Jelte-Boumans/Bachelorproef-Herstelsysteem-Ramen/Software/Assets/window_stap20.png

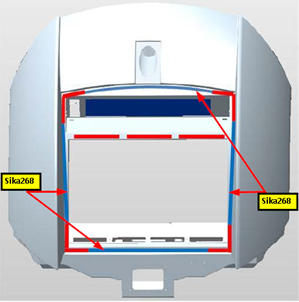
Software/Assets/window_stap20.png
