Jelte-Boumans/Bachelorproef-Herstelsysteem-Ramen/Software/Assets/window_stap22.png

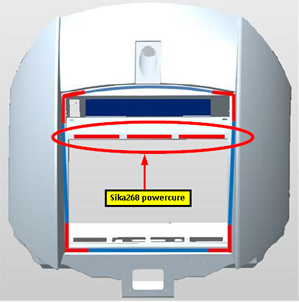
Software/Assets/window_stap22.png
