Jelte-Boumans/Bachelorproef-Herstelsysteem-Ramen/Documentatie/Analyse/Software analyse/Mockup Interface/Mockup - Powerpoint.pptx

## 1


## Slide 2
