Jelte-Boumans/Bachelorproef-Herstelsysteem-Ramen/Documentatie/Documenten/Foto's website/V2/Screenshot 2023-05-25 154047.png

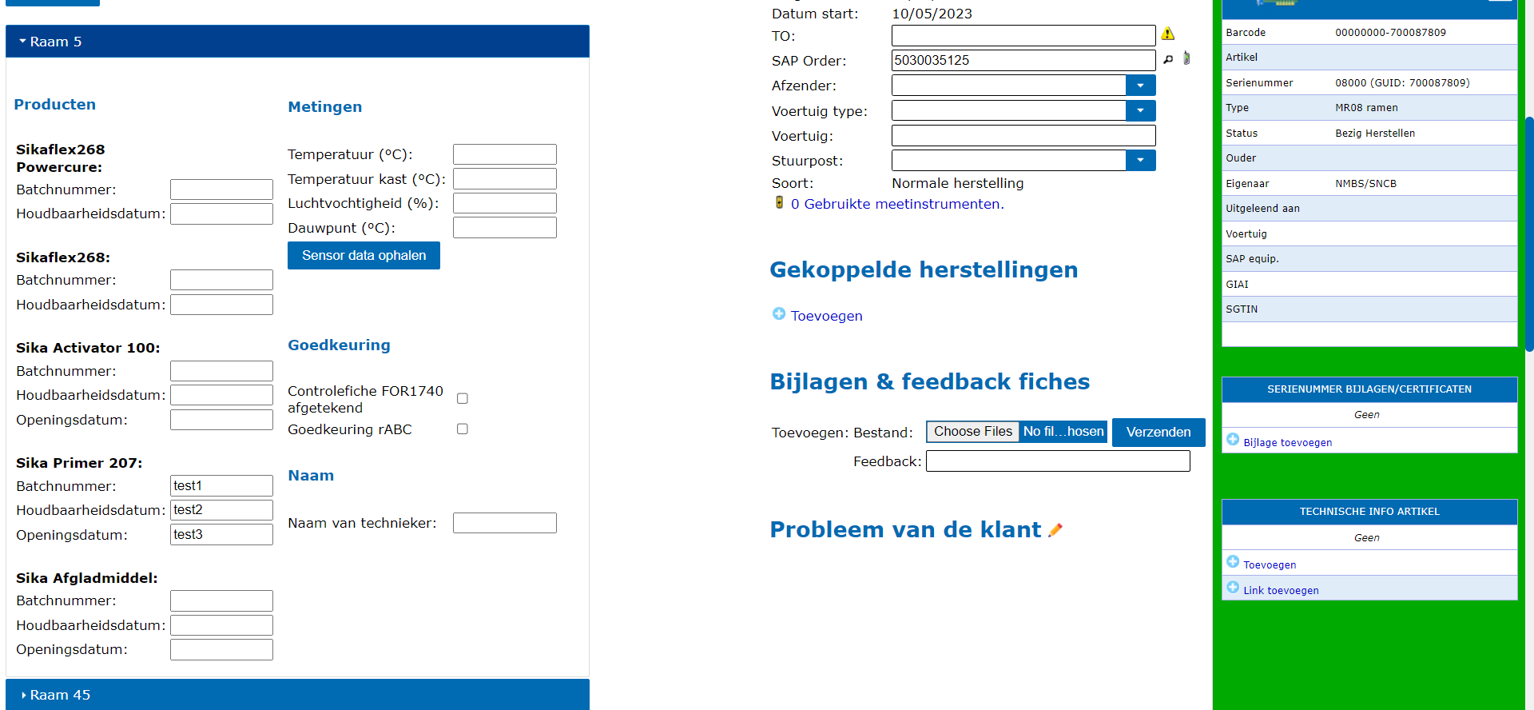
Documentatie/Documenten/Foto's website/V2/Screenshot 2023-05-25 154047.png
