Jelte-Boumans/Bachelorproef-Herstelsysteem-Ramen/Software/Assets/window_select.png

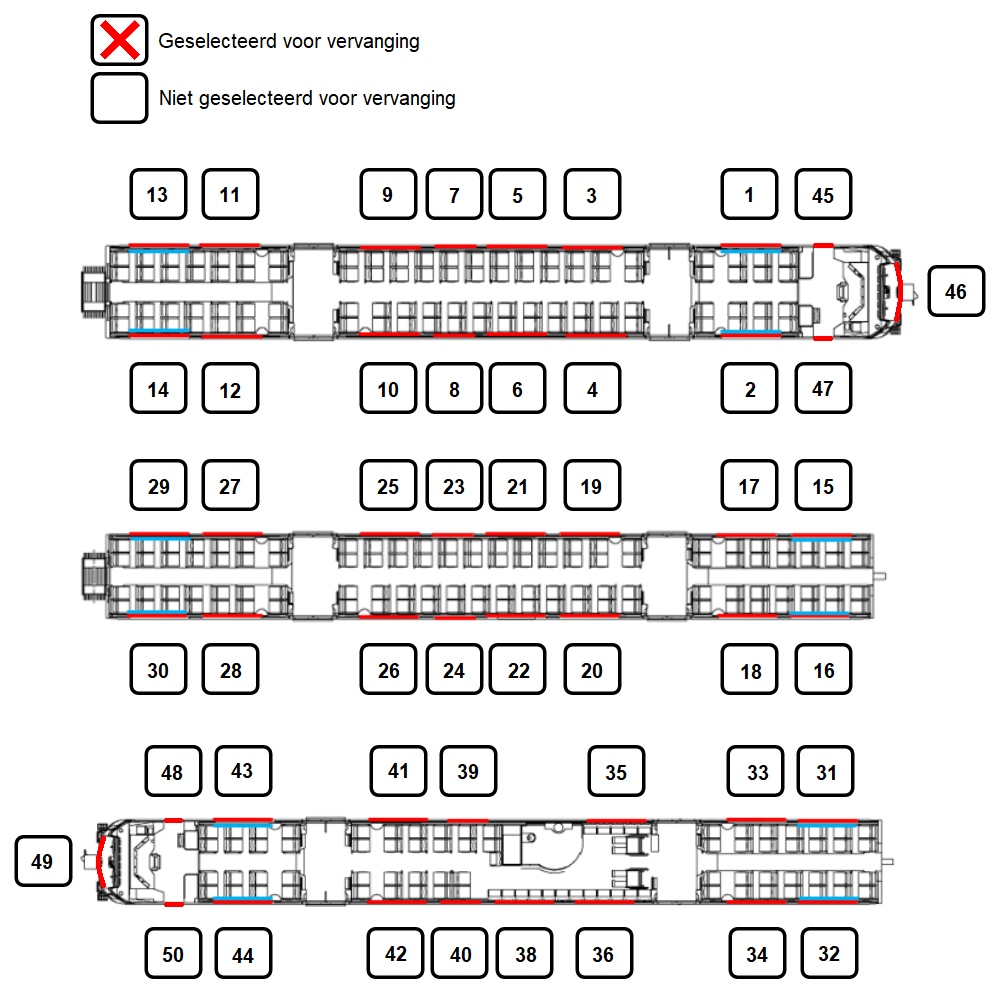
Software/Assets/window_select.png
