Jelte-Boumans/Bachelorproef-Herstelsysteem-Ramen/Documentatie/Analyse/Hardware analyse/V2/BOM.xlsx

Bill Of Materials - Stageopdracht Jelte Boumans
# | Qty | Component | Naam | Leverancier | Bestelnummer | Prijs/stuk | Prijs | Totaalprijs
1 | 1 | MCU | ATmega32U4 | Farnell | 1748525 | 5.180 € | 5.18 € | 36.51 €
2 | 1 | Sensor | BME680 | Mouser | 262-BME680 | 10.310 € | 10.31 €
3 | 1 | Spanningsregelaar | MCP1700T-3302E/TT | Farnell | 1296592 | 0.493 € | 0.49 €
4 | 1 | XTAL | LFXTAL071268 | Farnell | 2612479 | 1.140 € | 1.14 €
5 | 1 | Polyfuse | MSMF050-2 | Farnell | 9350314 | 0.500 € | 0.50 €
6 | 1 | Male USB C | CX60-24S-UNIT | Mouser | 798-CX60-24S-UNIT | 2.000 € | 2.00 €
7 | 1 | Display | Micro OLED 96x16 | Mouser | 790-EAW096016-XALW | 12.350 € | 12.35 €
8 | 1 | I2C level shifter | TCA9517DR | Farnell | 3009548 | 1.200 € | 1.20 €
9 | 1 | LED | SMD LED RED 0603 | Farnell | 2610406 | 0.365 € | 0.36 €
10 | 2 | LED | SMD LED GRN 0603 | Farnell | 2610409 | 0.365 € | 0.73 €
11 | 1 | Button | SMD Tactile Switch | Mouser | 611-PTS636SK50SMTRLF | 0.603 € | 0.60 €
12 | 5 | Weerstand | SMD 4k7Ω 0603 | Farnell | 2073509 | 0.012 € | 0.06 €
14 | 3 | Weerstand | SMD 1k5Ω 0603 | Farnell | 1717575 | 0.506 € | 1.52 €
15 | 2 | Weerstand | SMD 22Ω 0603 | Farnell | 2447301 | 0.013 € | 0.03 €
16 | 1 | Weerstand | SMD 10kΩ 0603 | Farnell | 2074167 | 0.010 € | 0.01 €
17 | 1 | Weerstand | SMD 910kΩ 0603 | Farnell | 2074318 | 0.013 € | 0.01 €
18 | 2 | Weerstand | SMD 5k1Ω 0603 | Farnell | 2447404 | 0.005 € | 0.01 €
19 | 2 | Condensator | SMD 100nF 0603 | Farnell | 2310603 | 0.007 € | 0.01 €
20 | 7 | Condensator | SMD 1µF 0603 | Farnell | 2210922 | 0.095 € | 0.66 €
21 | 2 | Condensator | SMD 22pF 0603 | Farnell | 1907288 | 0.044 € | 0.09 €
22 | 4 | Condensator | SMD 10µF 0603 | Farnell | 1867954 | 0.338 € | 1.35 €
