Jelte-Boumans/Bachelorproef-Herstelsysteem-Ramen/Hardware/Behuizing/Versie 1/Case V1 - Bovenkant.stl

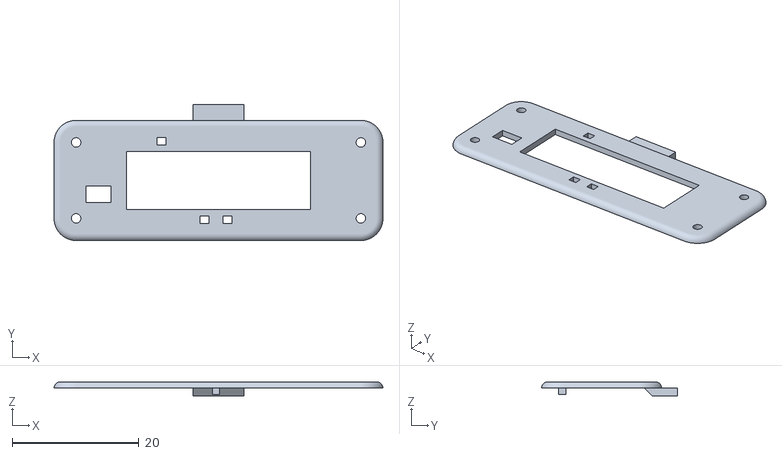
[picture p24: CAD file, 2023-05-04]
Hardware/Behuizing/Versie 1/Case V1 - Bovenkant.stl
52.0 x 21.5 x 2.25
