Jelte-Boumans/Bachelorproef-Herstelsysteem-Ramen/Hardware/Behuizing/Versie 2/Case V2 - Bovenkant.stl

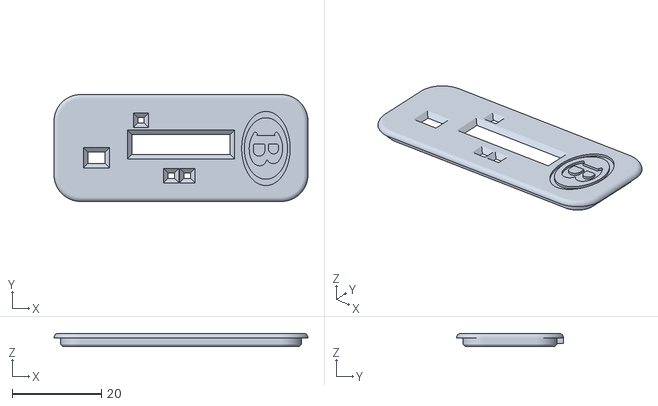
[picture p25: CAD file, 2023-05-04]
Hardware/Behuizing/Versie 2/Case V2 - Bovenkant.stl
57.0 x 24.0 x 3.00
