Jelte-Boumans/Bachelorproef-Herstelsysteem-Ramen/Hardware/Behuizing/Versie 1/Case V1 - Onderkant.stl

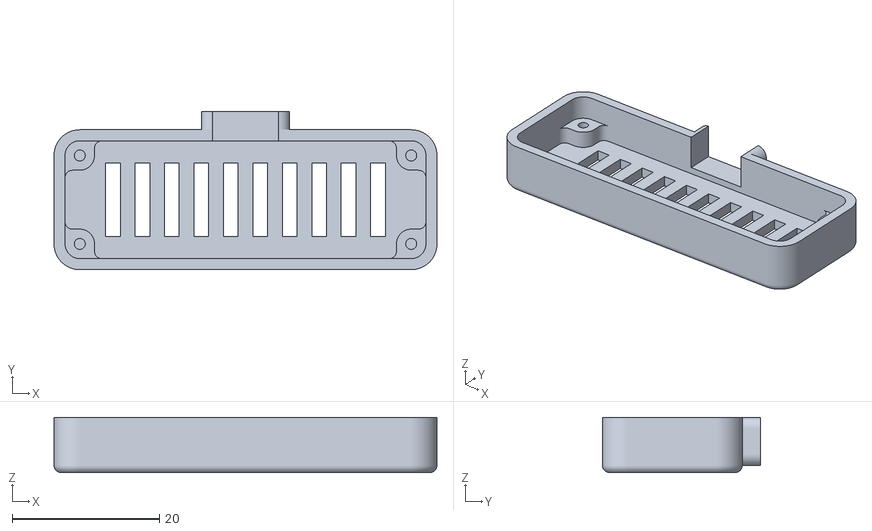
[picture p26: CAD file, 2023-05-04]
Hardware/Behuizing/Versie 1/Case V1 - Onderkant.stl
52.0 x 21.5 x 7.50
