Jelte-Boumans/Bachelorproef-Herstelsysteem-Ramen/Hardware/Behuizing/Versie 2/Case V2 - Onderkant.stl

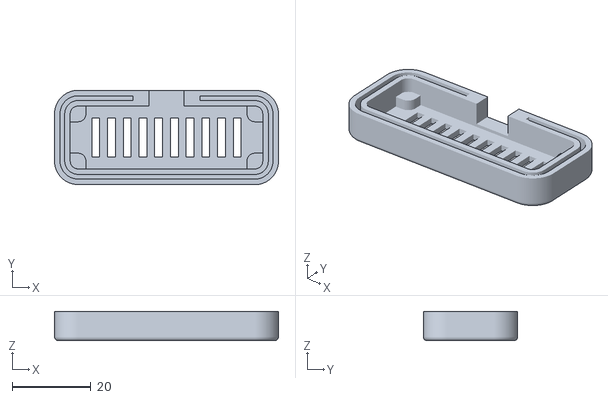
[picture p27: CAD file, 2023-05-04]
Hardware/Behuizing/Versie 2/Case V2 - Onderkant.stl
57.0 x 24.0 x 7.50
