Jelte-Boumans/Bachelorproef-Herstelsysteem-Ramen/(list of files, cad)

Other CAD files:
Hardware/Behuizing/Versie 1/Case V1.f3d
Hardware/Behuizing/Versie 1/PCB Case V1 (full assembly).f3z
Hardware/Behuizing/Versie 1/PCB V1.f3d
Hardware/Behuizing/Versie 2/Case V2.f3d
Hardware/Behuizing/Versie 2/PCB Case V2 (full assembly).f3z
Hardware/Behuizing/Versie 2/PCB V2.f3d
