Jelte-Boumans/Bachelorproef-Herstelsysteem-Ramen/Software/Stappenplan test/index.html

# Stap 1

Snij lijmvoeg in 4 stappen.

Plaats glasmanipulator haaks op de raam.

Snij de lijmvoeg tussen glas en wandbekleding door.

Verwijder raam en plaats het glas op een glasbok.

Ten slotte snij weg tot er nog ongeveer een 2mm kit blijft hangen.

# Stap 2

Reinig het nieuwe raam eerst volledig met Sika Cleaner.

Breng het product aan met een propere doek in 1 richting en wrijf met een nieuwe propere doek opnieuw in 1 richting weg.

# Stap 3

Breng aan de binnenzijde van de venster met een mouse Sika Primer 207 aan op de rand van het glas.

Breng op de beschadigde delen Sika Primer 207 aan met een mouse.

Laat minimum 30min drogen!

# Stap 4

Breng vervolgens Sika Activator 100 aan over de buitenrand van het glas.

Laat minimum 15min drogen!

Herhaal dit op de lijmrestanten van het raamkader.

# Stap 5

Plaats de rubber terug op de binnen bekleding.

Plaats positioneringsrubbers op de onderkant van de raam opening.

Neem het spuitpistool plaats de Lijm/mastiek Sikaflex-268 0.6l erin.

# Stap 6

Spuit Sikaflex 268 powercure rond het raam in de hoek van de raamzitting, maak hiervoor gebruik van de V-spuitmond.

Spuit een eerste lijmvoeg in de hoek van het vensterprofiel en een tweede lijmvoeg tegen de eerste lijmvoeg.

# Stap 7

Positioneer met 2 personen en de manipulator het glas in de raamopening op de positioneringsrubbers en duw het glas tegen de rubber van de binnenbekleding

Plaats de positioneringsplaatjes.

Verwijder de plaatjes na 1u!

Snij voorzichtig de naad tussen het glas en raamkader weg.

Spuit de voeg tussen het glas en de kast op met siliconespuit met Sikaflex 268 in een niet onderbroken lijmnaad.

# Stap 8

Breng afgladmiddel aan op de lijmvoeg

Strijk met een hulpstuk voor afkitten van ramen de lijmvoeg af tot een egale naad.

Vorige stap Volgende stap
