Jelte-Boumans/Bachelorproef-Herstelsysteem-Ramen/Hardware/Schemas/Bachelorproef V2/Bachelorproef V2.kicad_pcb

## KiCad design Hardware/Schemas/Bachelorproef V2/Bachelorproef V2.kicad_pcb (2023-05-30)

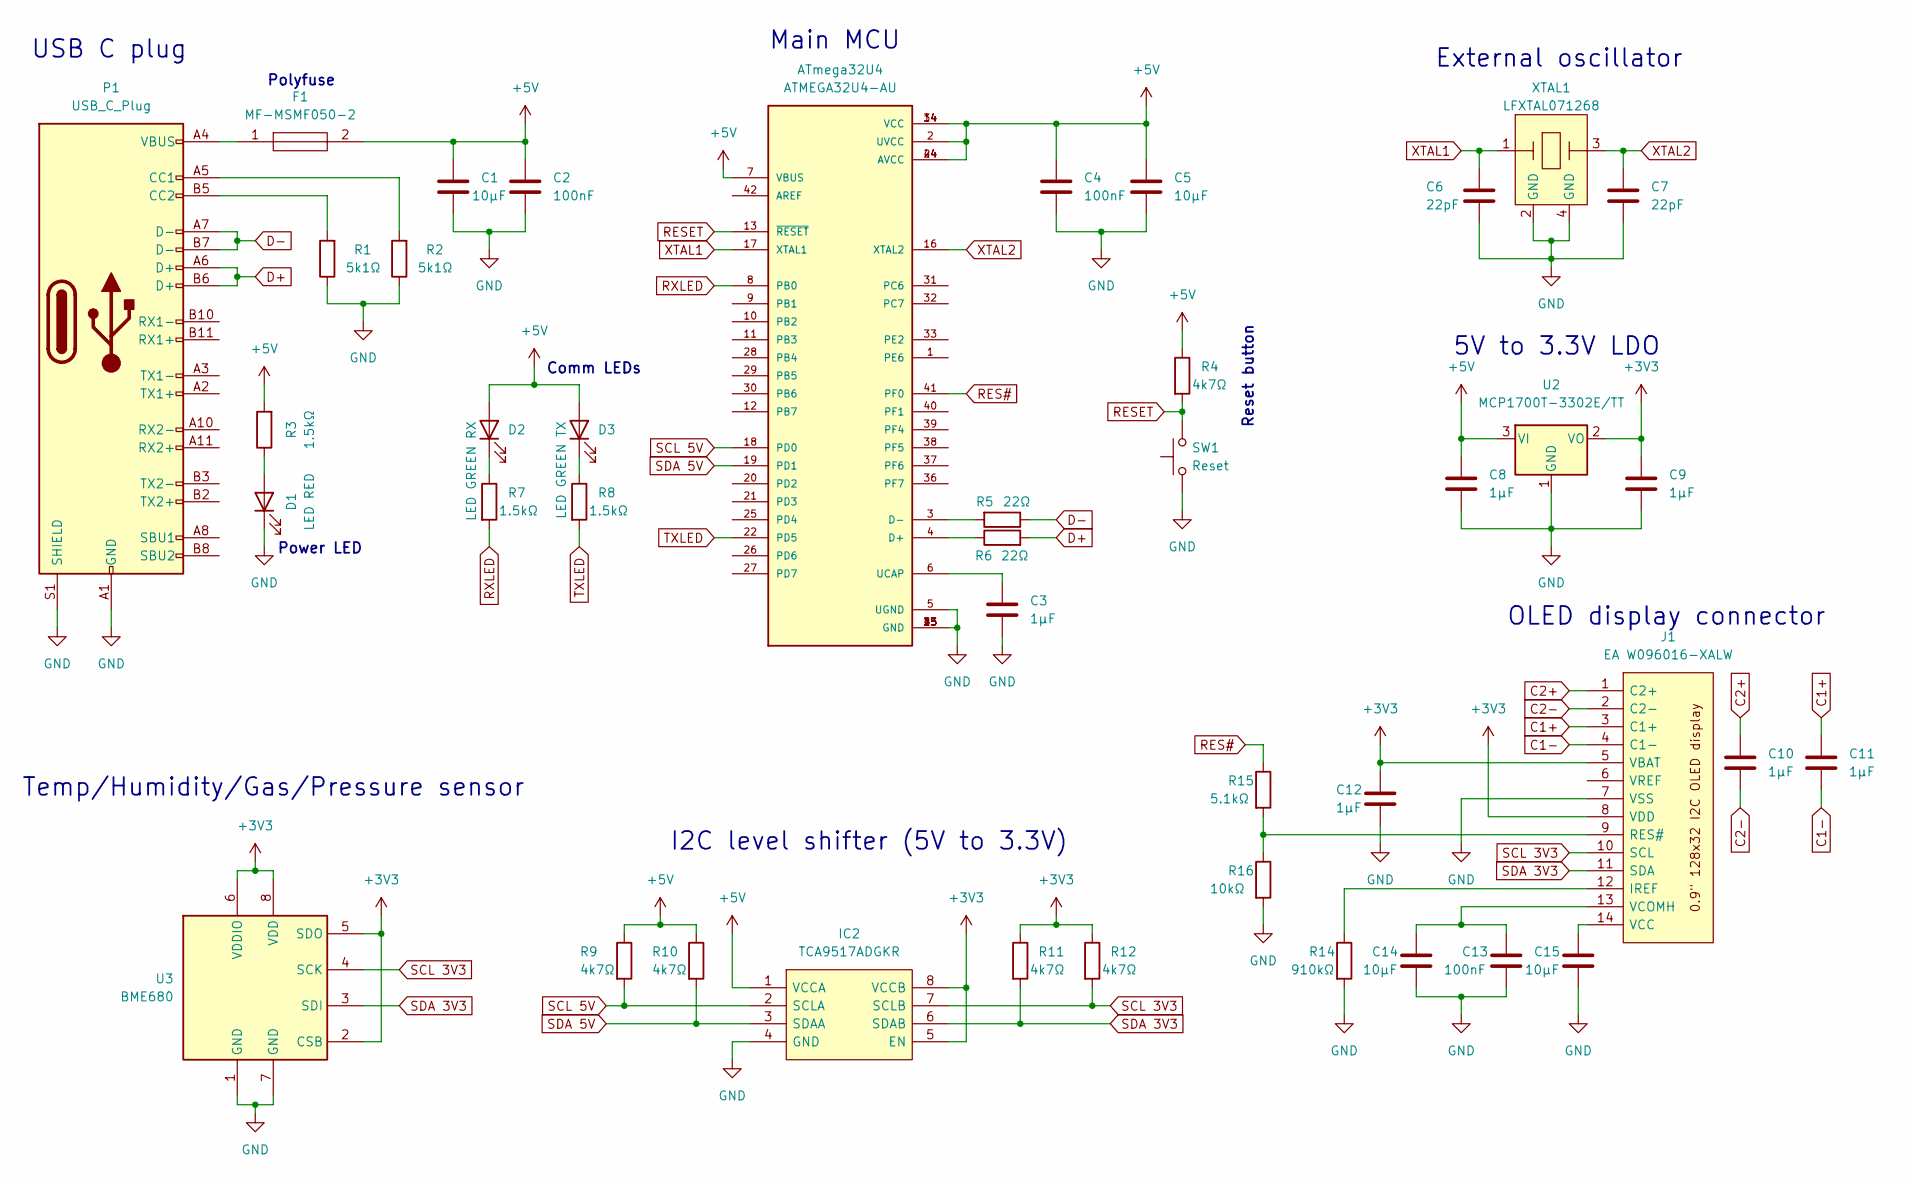
[picture p30: schematic Bachelorproef V2.kicad_sch]

Parts:
ATmega32U4: ATMEGA32U4-AU
C1, C5, C14, C15: 10µF; C_0603_1608Metric
C2, C4, C13: 100nF; C_0603_1608Metric
C3, C8, C9, C10, C11, C12: 1µF; C_0603_1608Metric
C6, C7: 22pF; C_0603_1608Metric
D1: LED RED; LED_0603_1608Metric_Pad1.05x0.95mm_HandSolder
D2: LED GREEN RX; LED_0603_1608Metric_Pad1.05x0.95mm_HandSolder
D3: LED GREEN TX; LED_0603_1608Metric_Pad1.05x0.95mm_HandSolder
F1: MF-MSMF050-2; Mouser Part Number 652-MF-MSMF050-2
IC2: TCA9517ADGKR
J1: EA W096016-XALW; EA_W096016-XALW
P1: USB_C_Plug; CX60-24S-UNIT
R1, R2: 5k1Ω; R_0603_1608Metric_Pad0.98x0.95mm_HandSolder
R3, R7, R8: 1.5kΩ; R_0603_1608Metric_Pad0.98x0.95mm_HandSolder
R4, R9, R10, R11, R12: 4k7Ω; R_0603_1608Metric_Pad0.98x0.95mm_HandSolder
R5, R6: 22Ω; R_0603_1608Metric_Pad0.98x0.95mm_HandSolder
R14: 910kΩ; R_0603_1608Metric_Pad0.98x0.95mm_HandSolder
R15: 5.1kΩ; R_0603_1608Metric_Pad0.98x0.95mm_HandSolder
R16: 10kΩ; R_0603_1608Metric_Pad0.98x0.95mm_HandSolder
SW1: Reset; SW_PTS636_SM43J_SMTR_LFS
U2: MCP1700T-3302E/TT; SOT-23
U3: BME680; Bosch_LGA-8_3x3mm_P0.8mm_ClockwisePinNumbering
XTAL1: LFXTAL071268

Connections:
+3V3: C9.1, C12.1, IC2.5 (EN), IC2.8 (VCCB), J1.5 (VBAT), J1.8 (VDD), R11.1, R12.1, U2.2 (VO), U3.2 (CSB), U3.5 (SDO), U3.6 (VDDIO), U3.8 (VDD)
+5V: ATmega32U4.2 (UVCC), ATmega32U4.7 (VBUS), ATmega32U4.14 (VCC), ATmega32U4.24 (AVCC), ATmega32U4.34 (VCC), ATmega32U4.44 (AVCC), C1.1, C2.1, C4.1, C5.1, C8.1, D2.2 (A), D3.2 (A), F1.2, IC2.1 (VCCA), R3.2, R4.1, R9.1, R10.1, U2.3 (VI)
C1+: C11.1, J1.3 (C1+)
C1-: C11.2, J1.4 (C1-)
C2+: C10.1, J1.1 (C2+)
C2-: C10.2, J1.2 (C2-)
D+: P1.A6 (D+), P1.B6 (D+), R6.2
D-: P1.A7 (D-), P1.B7 (D-), R5.1
GND: ATmega32U4.5 (UGND), ATmega32U4.15 (GND), ATmega32U4.23 (GND), ATmega32U4.35 (GND), ATmega32U4.43 (GND), C1.2, C2.2, C3.2, C4.2, C5.2, C6.2, C7.2, C8.2, C9.2, C12.2, C13.2, C14.2, C15.2, D1.1 (K), IC2.4 (GND), J1.7 (VSS), P1.A1 (GND), P1.A12 (GND), P1.B1 (GND), P1.B12 (GND), P1.S1 (SHIELD), R1.1, R2.1, R14.2, R16.2, SW1.1, U2.1 (GND), U3.1 (GND), U3.7 (GND), XTAL1.2 (GND), XTAL1.4 (GND)
unnamed: ATmega32U4.6 (UCAP), C3.1
unnamed: C13.1, C14.1, J1.13 (VCOMH)
unnamed: C15.1, J1.14 (VCC)
unnamed: D1.2 (A), R3.1
unnamed: D2.1 (K), R7.1
unnamed: D3.1 (K), R8.1
unnamed: F1.1, P1.A4 (VBUS), P1.A9 (VBUS), P1.B4 (VBUS), P1.B9 (VBUS)
unnamed: J1.9 (RES#), R15.2, R16.1
unnamed: J1.12 (IREF), R14.1
unnamed: P1.A5 (CC1), R2.2
unnamed: P1.B5 (CC2), R1.2
unnamed: ATmega32U4.3 (D-), R5.2
unnamed: ATmega32U4.4 (D+), R6.1
RES#: ATmega32U4.41 (PF0), R15.1
RESET: ATmega32U4.13 (~RESET), R4.2, SW1.2
RXLED: ATmega32U4.8 (PB0), R7.2
SCL 3V3: IC2.7 (SCLB), J1.10 (SCL), R12.2, U3.4 (SCK)
SCL 5V: ATmega32U4.18 (PD0), IC2.2 (SCLA), R9.2
SDA 3V3: IC2.6 (SDAB), J1.11 (SDA), R11.2, U3.3 (SDI)
SDA 5V: ATmega32U4.19 (PD1), IC2.3 (SDAA), R10.2
TXLED: ATmega32U4.22 (PD5), R8.2
XTAL1: ATmega32U4.17 (XTAL1), C6.1, XTAL1.1
XTAL2: ATmega32U4.16 (XTAL2), C7.1, XTAL1.3

Notes on the sheet:
Main MCU
Power LED
USB C plug
External oscillator
Reset button
I2C level shifter (5V to 3.3V)
Polyfuse
Temp/Humidity/Gas/Pressure sensor
OLED display connector
5V to 3.3V LDO
Comm LEDs

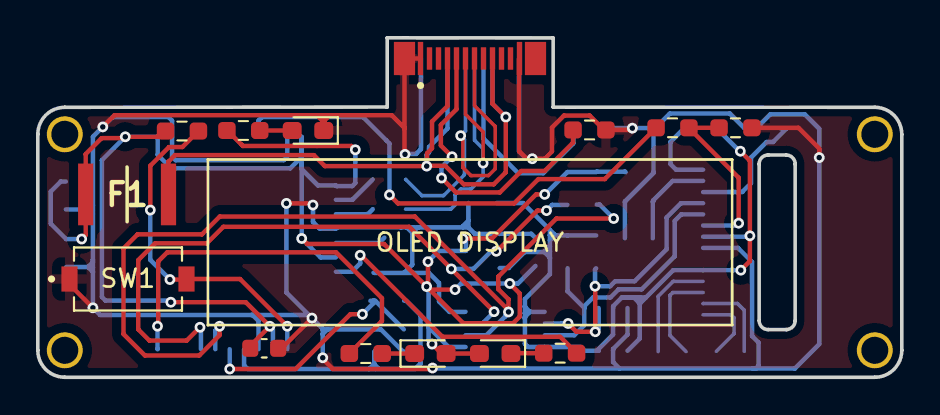
[picture p31: board Bachelorproef V2.kicad_pcb from above]

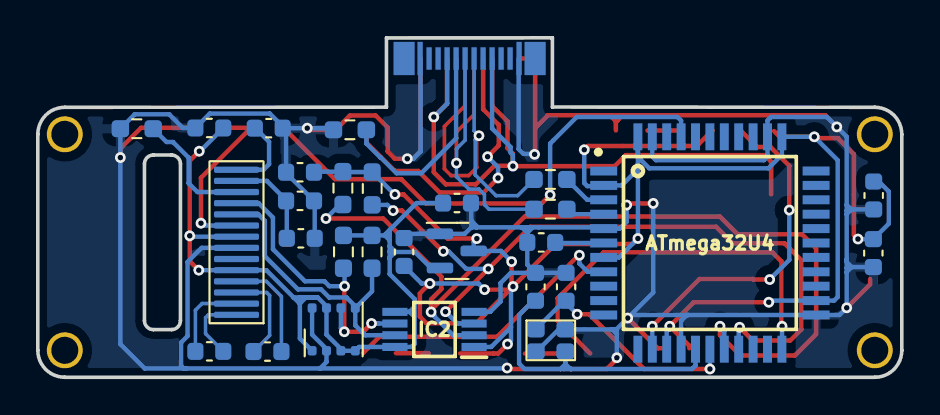
[picture p32: board Bachelorproef V2.kicad_pcb from below]

Board: 2 copper layers, 48.0 x 18.9 mm, 42 parts (28 on the bottom side), 32 nets.
