Jelte-Boumans/Bachelorproef-Herstelsysteem-Ramen/Hardware/Schemas/Bachelorproef V1/Bachelorproef V1.kicad_pcb

## KiCad design Hardware/Schemas/Bachelorproef V1/Bachelorproef V1.kicad_pcb (2023-05-23, an earlier design)

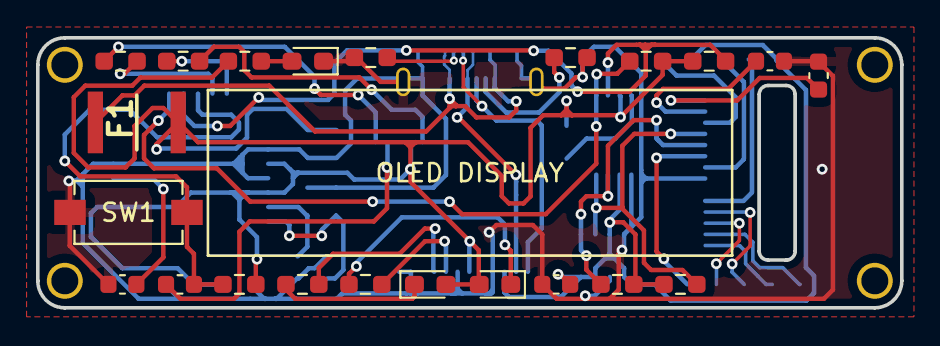
[picture p33: board Bachelorproef V1.kicad_pcb from above]

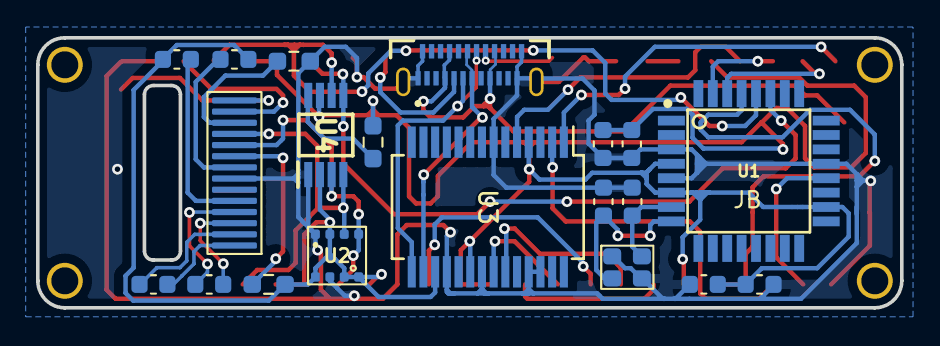
[picture p34: board Bachelorproef V1.kicad_pcb from below]

Board: 2 copper layers, 48.0 x 15.0 mm, 42 parts (20 on the bottom side), 37 nets.

Parts:
C1, C7, C10, C11, C12, C13: 1µF; C_0603_1608Metric
C2, C3, C4, C5, C6: 100nF; C_0603_1608Metric
C8, C9: 22pF; C_0603_1608Metric
C14, C15: 10µF; C_0603_1608Metric
D1: LED RED; LED_0603_1608Metric_Pad1.05x0.95mm_HandSolder
D2: LED GREEN RX; LED_0603_1608Metric_Pad1.05x0.95mm_HandSolder
D3: LED GREEN TX; LED_0603_1608Metric_Pad1.05x0.95mm_HandSolder
F1: MF-MSMF050-2
J1: EA W096016-XALW; EA_W096016-XALW
P1: USB_C_Plug; USB4155-03-C
R1: 150; R_0603_1608Metric_Pad0.98x0.95mm_HandSolder
R2, R3: 5K1; R_0603_1608Metric_Pad0.98x0.95mm_HandSolder
R4, R5: 1K; R_0603_1608Metric_Pad0.98x0.95mm_HandSolder
R6, R7: 120; R_0603_1608Metric_Pad0.98x0.95mm_HandSolder
R8, R9, R10, R11, R12: 4K7; R_0603_1608Metric_Pad0.98x0.95mm_HandSolder
R13, R15: 390K; R_0603_1608Metric_Pad0.98x0.95mm_HandSolder
R14: 10K; R_0603_1608Metric_Pad0.98x0.95mm_HandSolder
SW1: Reset; SW_PTS636_SM43J_SMTR_LFS
U1: ATMEGA328P-AU
U2: BME680; Bosch_LGA-8_3x3mm_P0.8mm_ClockwisePinNumbering
U3: FT232RL; SSOP-28_5.3x10.2mm_P0.65mm
U4: PI6ULS5V9306; TCA9517ADGKR
XTAL1: LFXTAL071268

Connections:
+3V3: C3.2, C12.1, C13.1, R11.1, R12.1, R14.1, U2.2 (CSB), U2.5 (SDO), U2.6 (VDDIO), U2.8 (VDD), U3.17 (3V3OUT), U4.2 (Vcc_A)
+5V: C1.1, C2.1, C6.1, C7.1, D2.2 (A), D3.2 (A), F1.2, R1.2, R8.1, R9.1, R10.1, R13.1, U1.4 (VCC), U1.6 (VCC), U1.18 (AVCC), U3.4 (VCCIO), U3.20 (VCC), U4.7 (Vcc_B)
C1+: C11.1, J1.3 (C1+)
C1-: C11.2, J1.4 (C1-)
C2+: C10.1, J1.1 (C2+)
C2-: C10.2, J1.2 (C2-)
D+: P1.A6 (D+), P1.B6 (D+), U3.15 (USBD+)
D-: P1.A7 (D-), P1.B7 (D-), U3.16 (USBD-)
GND: C1.2, C2.2, C3.1, C5.1, C6.2, C7.2, C8.2, C9.2, C14.2, C15.2, D1.1 (K), J1.7 (VSS), P1.A1 (GND), P1.A12 (GND), P1.B1 (GND), P1.B12 (GND), P1.S1 (SHIELD), R2.1, R3.1, R15.2, SW1.1, U1.3 (GND), U1.5 (GND), U1.21 (GND), U2.1 (GND), U2.7 (GND), U3.7 (GND), U3.18 (GND), U3.21 (GND), U3.25 (AGND), U3.26 (TEST), U4.1 (GND), XTAL1.2 (GND), XTAL1.4 (GND)
unnamed: C4.1, U3.2 (DTR)
unnamed: C5.2, U1.20 (AREF)
unnamed: C12.2, J1.8 (VDD)
unnamed: C13.2, J1.5 (VBAT)
unnamed: C14.1, J1.13 (VCOMH)
unnamed: C15.1, J1.14 (VCC)
unnamed: D1.2 (A), R1.1
unnamed: D2.1 (K), R6.1
unnamed: D3.1 (K), R7.1
unnamed: F1.1, P1.A4 (VBUS), P1.A9 (VBUS), P1.B4 (VBUS), P1.B9 (VBUS)
unnamed: J1.9 (RES#), R14.2
unnamed: J1.12 (IREF), R15.1
unnamed: P1.A5 (CC1), R3.2
unnamed: P1.B5 (CC2), R2.2
unnamed: R4.2, U3.1 (TXD)
unnamed: R5.2, U3.5 (RXD)
unnamed: R6.2, U3.23 (CBUS0)
unnamed: R7.2, U3.22 (CBUS1)
unnamed: R13.2, U4.8 (EN)
RESET: C4.2, R8.2, SW1.2, U1.29 (PC6/~RESET)
RX: R4.1, U1.30 (PD0)
SCL 3V3: J1.10 (SCL), R12.2, U2.4 (SCK), U4.3 (SCL_A)
SCL 5V: R9.2, U1.28 (PC5), U4.6 (SCL_A)
SDA 3V3: J1.11 (SDA), R11.2, U2.3 (SDI), U4.4 (SDA_A)
SDA 5V: R10.2, U1.27 (PC4), U4.5 (SDA_B)
TX: R5.1, U1.31 (PD1)
XTAL1: C8.1, U1.7 (PB6), XTAL1.1
XTAL2: C9.1, U1.8 (PB7), XTAL1.3
